pratikop/USV-Electrical-Architecture/pdf/USV_Electrical_Drawings_RevE.pdf

1 | 2 | 3 | 4 | 5 | 6 | 7 | 8
A | A
B | B
C | C
D | D
E | E

# E-001 DESIGN BASIS, SINGLE-LINE ARCHITECTURE AND POWER BUDGET

Independent conceptual study — unbuilt and unvalidated.

## ENV-USV-01 | CIVILIAN WATER-QUALITY MONITORING

## Design basis, single-line architecture and power budget

Author: Pratik Prabhakar Shinde | INDEPENDENT CONCEPT DESIGN

DXF R2013 / Layered vector drawing / A3 landscape

### DRAWING: E-001

REV: E / 17 OCT 2026

STATUS: CONCEPT

PURPOSE: PORTFOLIO

A3 / 420 x 297 mm

SCALE: NTS

UNITS: mm (sheet)

PLOT: 1:1 / LANDSCAPE

## 1. DESIGN BASIS

Mission: 2 h sheltered-water environmental survey; visual supervision and recovery support. Nonconductive 2-3 m hull assumed. Displacement, speed, thrust and battery mass are unresolved. B1: 8S LiFePO4 / 25.6 V nominal / 100 Ah / planning range 22.4-29.2 V.
No charger aboard. Remove/isolate pack for approved shore charging. No AC system in scope.

## 2. FUNCTIONAL SINGLE-LINE (RETURNS OMITTED ON THIS SHEET)

## B1 + BMS

25.6 V / 100 Ah
BMS >=100 A assumed

F0 / Q0

80 A main fuse
2-pole manual isolator

## K1 / F1-F2

Propulsion contactor
2 x 40 A DC feeders

## ESC1 / M1

Port: 300 / 600 W

## ESC2 / M2

Stbd: 300 / 600 W

## F3 / D1 / F5

24 V class -> 12 V
120 W DC/DC; 7.5 A out

## F6-F10 / 12 V SERVICES

Autopilot, GNSS, logger, telemetry, payload 60 W baseline; detailed branches on E-003

## 3. POWER BUDGET - ASSUMED ELECTRICAL INPUTS

LOAD | CRUISE W | PEAK W | BASIS
Propulsion (2 thrusters) | 600 | 1200 | 2 x 300 / 600 W
12 V services | 60 | 60 | D1 output load
D1 conversion loss | 6.7 | 6.7 | 90% efficiency
Permit/control coils | 4 | 4 | Allowance incl. relay drives
TOTAL AT BATTERY | 670.7 | 1270.7 | Simultaneous peak

ENERGY ESTIMATE (NOT MEASURED)

Nominal: 25.6 x 100 = 2560 Wh

Planning: 1843 Wh (SOC x capacity factors)

Mission: 670.7 W x 2 h = 1341 Wh

Estimated endurance: 2.75 h

At 900 W propulsion: 1.90 h

Cable/contact losses not explicitly added.

See calculations/calculations.md.

# E-002 MAIN DC DISTRIBUTION AND PROPULSION FEEDERS

## POWER CIRCUITS / SIMPLIFIED DEVICE SYMBOLS / ALL CONTACTS SHOWN DE-ENERGIZED

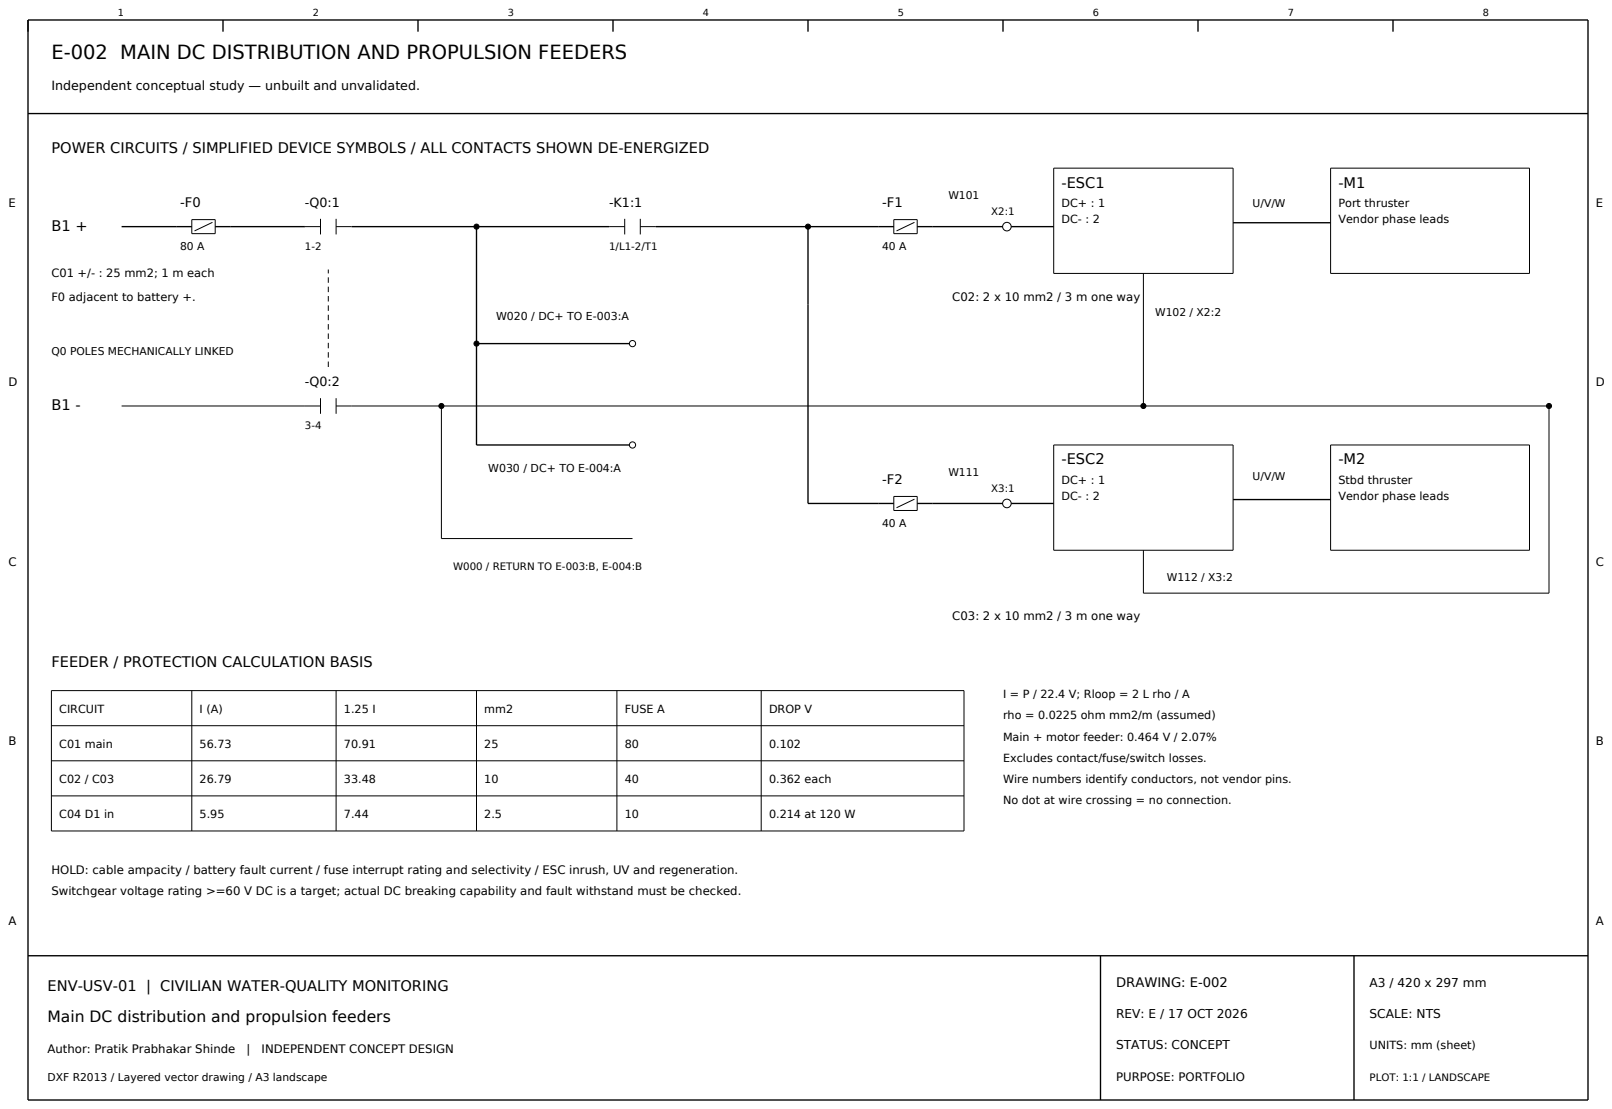
[picture p1: page 2]
DRAWING: E-002; REV: E / 17 OCT 2026; SCALE: NTS; C01 +/- : 25 mm2; 1 m each; -ESC1; C02: 2 x 10 mm2 / 3 m one way; -ESC2; C03: 2 x 10 mm2 / 3 m one way; W000 / RETURN TO E-003:B, E-004:B; I = P / 22.4 V; Rloop = 2 L rho / A

Independent conceptual study — unbuilt and unvalidated.

Port thruster
Vendor phase leads

F0 adjacent to battery +.

Q0 POLES MECHANICALLY LINKED

Stbd thruster

FEEDER / PROTECTION CALCULATION BASIS

CIRCUIT | I (A) | 1.25 I | mm2 | FUSE A | DROP V

rho = 0.0225 ohm mm2/m (assumed)

Main + motor feeder: 0.464 V / 2.07%

C01 main | 56.73 | 70.91 | 25 | 80 | 0.102

Excludes contact/fuse/switch losses.

C02 / C03 | 26.79 | 33.48 | 10 | 40 | 0.362 each

Wire numbers identify conductors, not vendor pins.

No dot at wire crossing = no connection.

HOLD: cable ampacity / battery fault current / fuse interrupt rating and selectivity / ESC inrush, UV and regeneration.
Switchgear voltage rating >=60 V DC is a target; actual DC breaking capability and fault withstand must be checked.

ENV-USV-01 | CIVILIAN WATER-QUALITY MONITORING

Main DC distribution and propulsion feeders

# E-003 12 V SERVICES, FIELD TERMINALS AND SENSOR INTERFACES

## 24 V CLASS TO 12 V SUPPLY / NON-ISOLATED CONVERTER / DEDICATED COPPER RETURNS

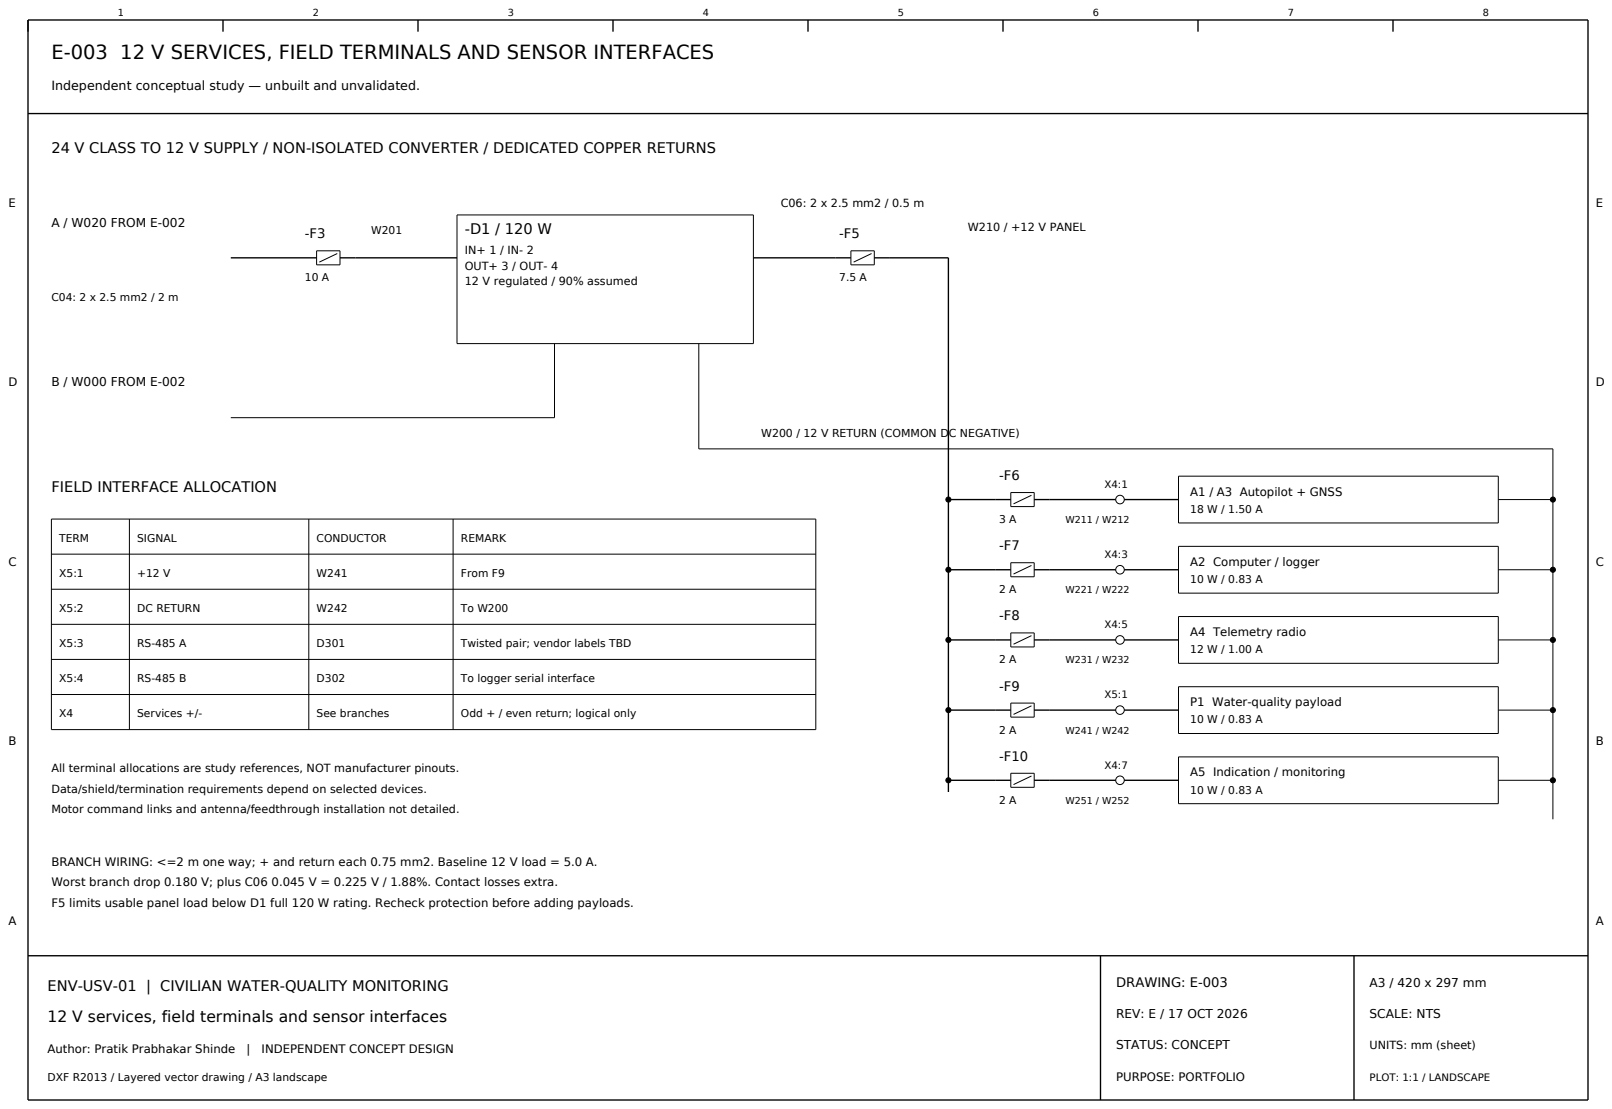
[picture p2: page 3]
DRAWING: E-003; REV: E / 17 OCT 2026; SCALE: NTS; A / W020 FROM E-002; IN+ 1 / IN- 2 OUT+ 3 / OUT- 4 12 V regulated / 90% assumed; W210 / +12 V PANEL; B / W000 FROM E-002; A1 / A3 Autopilot + GNSS; A2 Computer / logger; A4 Telemetry radio; A5 Indication / monitoring

Independent conceptual study — unbuilt and unvalidated.

W200 / 12 V RETURN (COMMON DC NEGATIVE)

FIELD INTERFACE ALLOCATION

TERM | SIGNAL | CONDUCTOR | REMARK

X5:1 | +12 V | W241 | From F9

X5:2 | DC RETURN | W242 | To W200

X5:3 | RS-485 A | D301 | Twisted pair; vendor labels TBD

X5:4 | RS-485 B | D302 | To logger serial interface

P1 Water-quality payload

X4 | Services +/- | See branches | Odd + / even return; logical only

All terminal allocations are study references, NOT manufacturer pinouts.
Data/shield/termination requirements depend on selected devices.
Motor command links and antenna/feedthrough installation not detailed.

BRANCH WIRING: <=2 m one way; + and return each 0.75 mm2. Baseline 12 V load = 5.0 A.
Worst branch drop 0.180 V; plus C06 0.045 V = 0.225 V / 1.88%. Contact losses extra.
F5 limits usable panel load below D1 full 120 W rating. Recheck protection before adding payloads.

ENV-USV-01 | CIVILIAN WATER-QUALITY MONITORING

12 V services, field terminals and sensor interfaces

A | A
B | B
C | C
D | D
E | E

# E-004 PROPULSION PERMIT AND PROPOSED COMMISSIONING PROCEDURES

Independent conceptual study — unbuilt and unvalidated.

## ENV-USV-01 | CIVILIAN WATER-QUALITY MONITORING

## Propulsion permit and proposed commissioning procedures

### DRAWING: E-004

REV: E / 17 OCT 2026

A3 / 420 x 297 mm

SCALE: NTS

## HARDWARE PERMIT PATH - FUNCTIONAL CONTACT DIAGRAM, NOT A RELEASED SAFETY CIRCUIT

A / W030 FROM E-002

-F4

1 A

-S1

11-12 / NC

-SR1

13-14 / NO

-K2

13-14 / NO

-K1

A1 A2

B / W000 TO E-002

W301 | W302 | W303 | W304

C05: 0.75 mm2; 2 m equivalent loop assumption; suppression and relay supply wiring are not detailed.

## -SR1 / MANUAL PERMIT

Functional module; not selected. Requires deliberate reset/arm action. No auto re-arm after power/stop reset. Reset and feedback terminals TBD.

## -K2 / WATCHDOG PERMIT

NO contact only while heartbeat valid. >1 s timeout -> neutral, then open K1. HW/SW implementation not provided. Failure-high behaviour unresolved.

## -K1 / PROPULSION CONTACTOR

Main contact on E-002; auxiliary stays live. Auxiliary feedback needed for fault detection. Coil suppression / drop-out time TBD.
Welded contact can defeat isolation.

### PROPOSED COMMISSIONING PROCEDURES - PRELIMINARY ACCEPTANCE TARGETS / NOT EXECUTED

TEST | METHOD | PROPOSED ACCEPTANCE / HOLD POINT
T01-03 | Pre-energization review | Datasheets, fault current, polarity, torque, return continuity and BMS limits approved.
T04 | Current-limited supply | 12 V panel remains 11.4-12.6 V at 60 W; no reset over intended input range.
T05 | Guarded load emulation | Cable-only propulsion path drop <=3%; ESC input above UV limit; thermal limits met.
T06-07 | Stop / heartbeat loss | Proposed K1 power removal <=0.5 s on local stop; >1 s timeout response; manual re-arm.
T08-09 | Ingress / wet motor setup | Approved facility/procedure; record transients; fault/feedback response reviewed.
T10 | Supervised water trial | 2 h within pack/SOC/thermal limits; log V/I/Wh and conditions; recovery support.

No deliberate pack short circuit. No dry-running water-cooled thrusters. Power removal does not prove stopped thrust or vessel motion.

A | A
B | B
C | C
D | D
E | E

# E-005 CABLE SCHEDULE, PRELIMINARY MATERIALS AND DRAWING NOTES

Independent conceptual study — unbuilt and unvalidated.

## ENV-USV-01 | CIVILIAN WATER-QUALITY MONITORING

## Cable schedule, preliminary materials and drawing notes

### DRAWING: E-005

REV: E / 17 OCT 2026

A3 / 420 x 297 mm

SCALE: NTS

## CABLE TAKE-OFF - CONDUCTOR-METRES, INCLUDING 20% ROUTING ALLOWANCE

ID | FROM / TO | L ONE-WAY | CORE mm2 | CORES | PROV. m | PROTECTION / HOLD
C01 | B1 / F0 / Q0 / DC bars | 1.0 m | 25 | 2 | 2.4 | F0 80 A / assumed Iz 100 A
C02 | K1 / F1 / ESC1 + return | 3.0 m | 10 | 2 | 7.2 | F1 40 A / assumed Iz 50 A
C03 | K1 / F2 / ESC2 + return | 3.0 m | 10 | 2 | 7.2 | F2 40 A / assumed Iz 50 A
C04 | F3 / D1 input + return | 2.0 m | 2.5 | 2 | 4.8 | F3 10 A / assumed Iz 20 A
C05 | F4 / stop-permit / K1 coil | 2.0 m eq. | 0.75 | 2 eq. | 4.8 | F4 1 A / assumed Iz 5 A
C06 | D1 / F5 / 12 V panel | 0.5 m | 2.5 | 2 | 1.2 | F5 7.5 A / assumed Iz 20 A
12V-BR | F6-F10 / service loads | 2 m each | 0.75 | 2 x 5 | 24.0 | F6 3 A; F7-F10 2 A

## PRELIMINARY FUNCTIONAL BOM (NO PART NUMBERS OR COST CLAIM)

TAG | QTY | FUNCTIONAL SPECIFICATION | RELEASE HOLD
B1 / F0 / Q0 | 1 set | 25.6 V 100 Ah; 80 A fuse; >=100 A isolator | Fault current, BMS, DC break, mass
K1 / ESC / M | 1/2/2 | >=100 A contactor; 600 W peak per propulsion branch | ESC UV <=21 V; inrush / regen / cooling
D1 / F3-F10 | 1 set | 12 V 120 W DC/DC and branch fuse/holder set | Actual voltage range, protection coordination
S1 / SR1 / K2 | 1 each | NC local stop; manual permit; watchdog permit | Exact reset / feedback and fault behaviour
A1-A5 / P1 | 1 set | Autopilot, GNSS, logger, radio, monitoring, sensors | Supply compatibility, data protocols and EMC
ENC / cabling | 1 lot | Sealed enclosure, glands, connectors, copper, terminals | IP67 assembly target; heat / corrosion review

## GENERAL DRAWING / DESIGN NOTES

1. NTS schematic sheets. Model-space coordinates are paper mm. Open DXF in AutoCAD; plot A3 landscape 1:1.
2. Simplified conventional symbols only. Tags/terminal allocations are illustrative, not vendor connection instructions.
3. All ampacities are assumptions. Validate installation derating, connector ratings and fuse curves before design release.
4. Single battery, BMS and converter remain common failure points. No redundancy or standards compliance is claimed.
5. Rev E: consolidated portfolio presentation. Electrical architecture and analytical sizing are unchanged.
6. Sources: Victron Wiring Unlimited, DC wiring; Blue Sea Systems Circuit Protection. Full links in docs/engineering_brief.md.
7. Results are analytical estimates. Commissioning procedures are proposed and have not been executed.
