pratikop/USV-Electrical-Architecture/cad/E-002.dxf

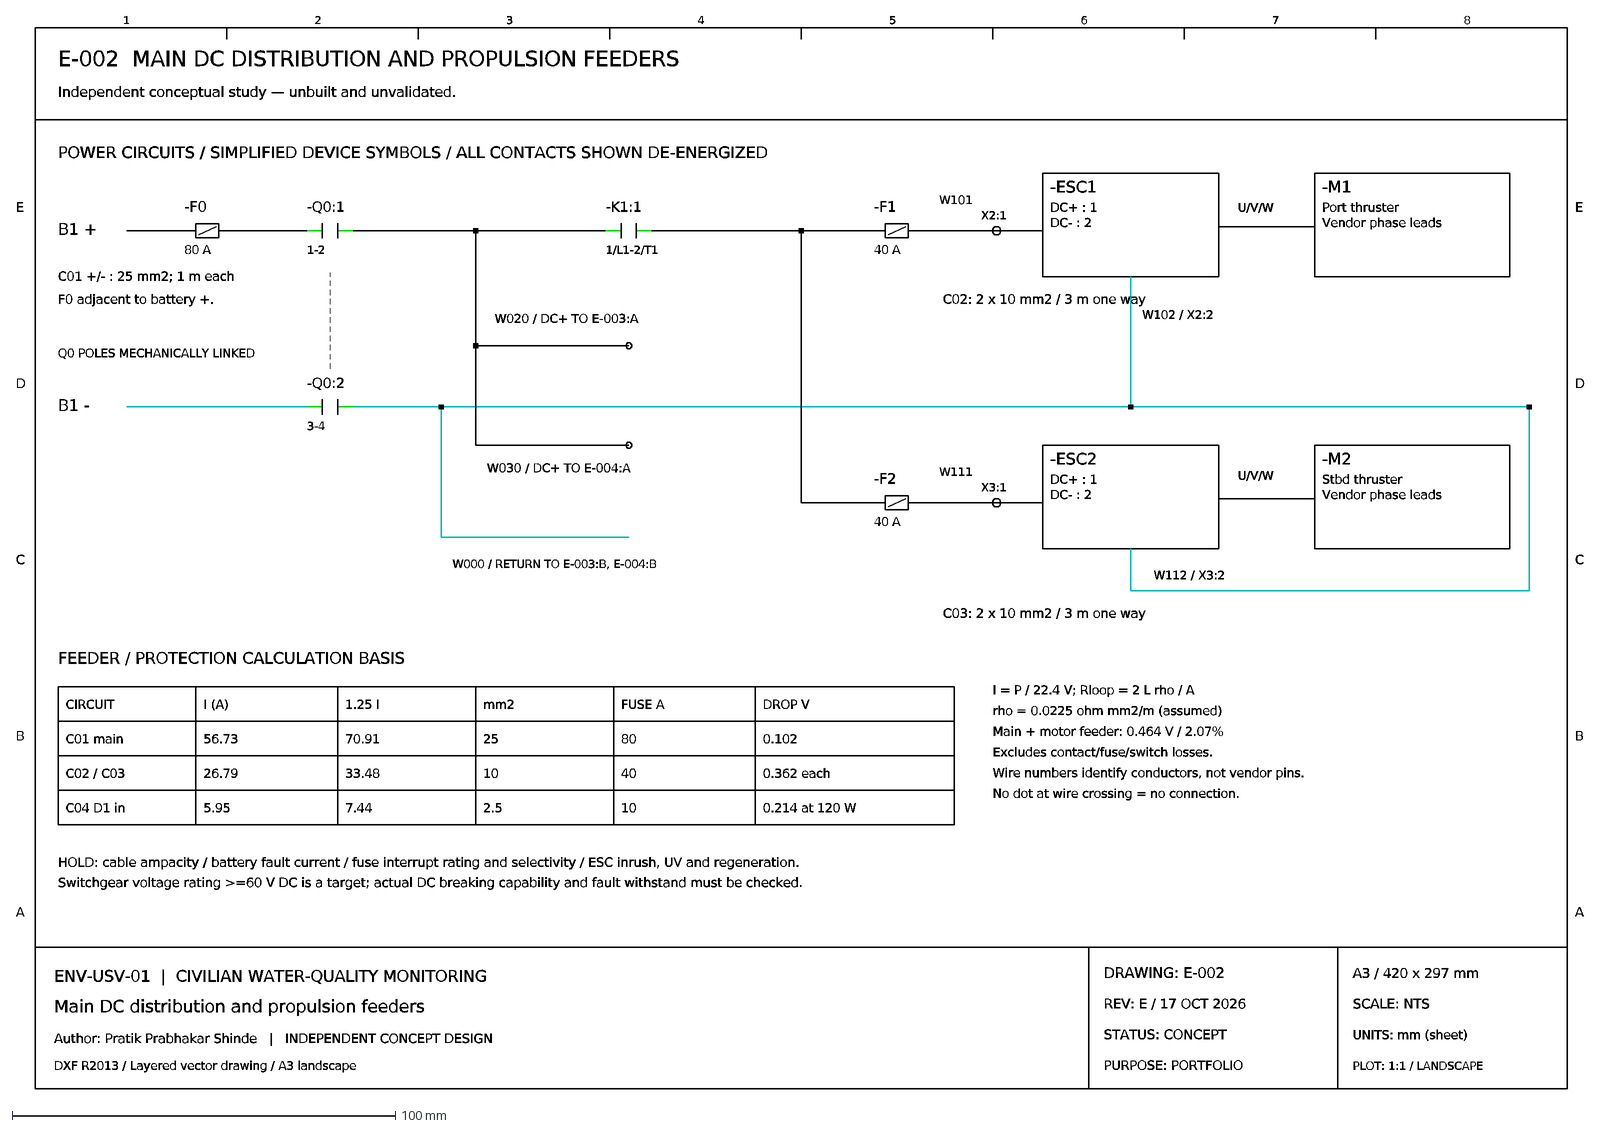
[picture p3: CAD file, 2026-10-17]
cad/E-002.dxf
1
2
3
4
5
6
7
8
A
B
C
D
E
E-002 MAIN DC DISTRIBUTION AND PROPULSION FEEDERS
Independent conceptual study — unbuilt and unvalidated.
ENV-USV-01 | CIVILIAN WATER-QUALITY MONITORING
Main DC distribution and propulsion feeders
Author: Pratik Prabhakar Shinde | INDEPENDENT CONCEPT DESIGN
DXF R2013 / Layered vector drawing / A3 landscape
DRAWING: E-002
REV: E / 17 OCT 2026
STATUS: CONCEPT
PURPOSE: PORTFOLIO
A3 / 420 x 297 mm
SCALE: NTS
UNITS: mm (sheet)
PLOT: 1:1 / LANDSCAPE
POWER CIRCUITS / SIMPLIFIED DEVICE SYMBOLS / ALL CONTACTS SHOWN DE-ENERGIZED
B1 +
-F0
80 A
-Q0:1
1-2
B1 -
-Q0:2
3-4
Q0 POLES MECHANICALLY LINKED
C01 +/- : 25 mm2; 1 m each
F0 adjacent to battery +.
-K1:1
1/L1-2/T1
-F1
40 A
X2:1
W101
-ESC1
DC+ : 1
DC- : 2
-M1
Port thruster
Vendor phase leads
U/V/W
W102 / X2:2
C02: 2 x 10 mm2 / 3 m one way
-F2
X3:1
W111
-ESC2
W112 / X3:2
-M2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
