pratikop/USV-Electrical-Architecture/cad/E-003.dxf

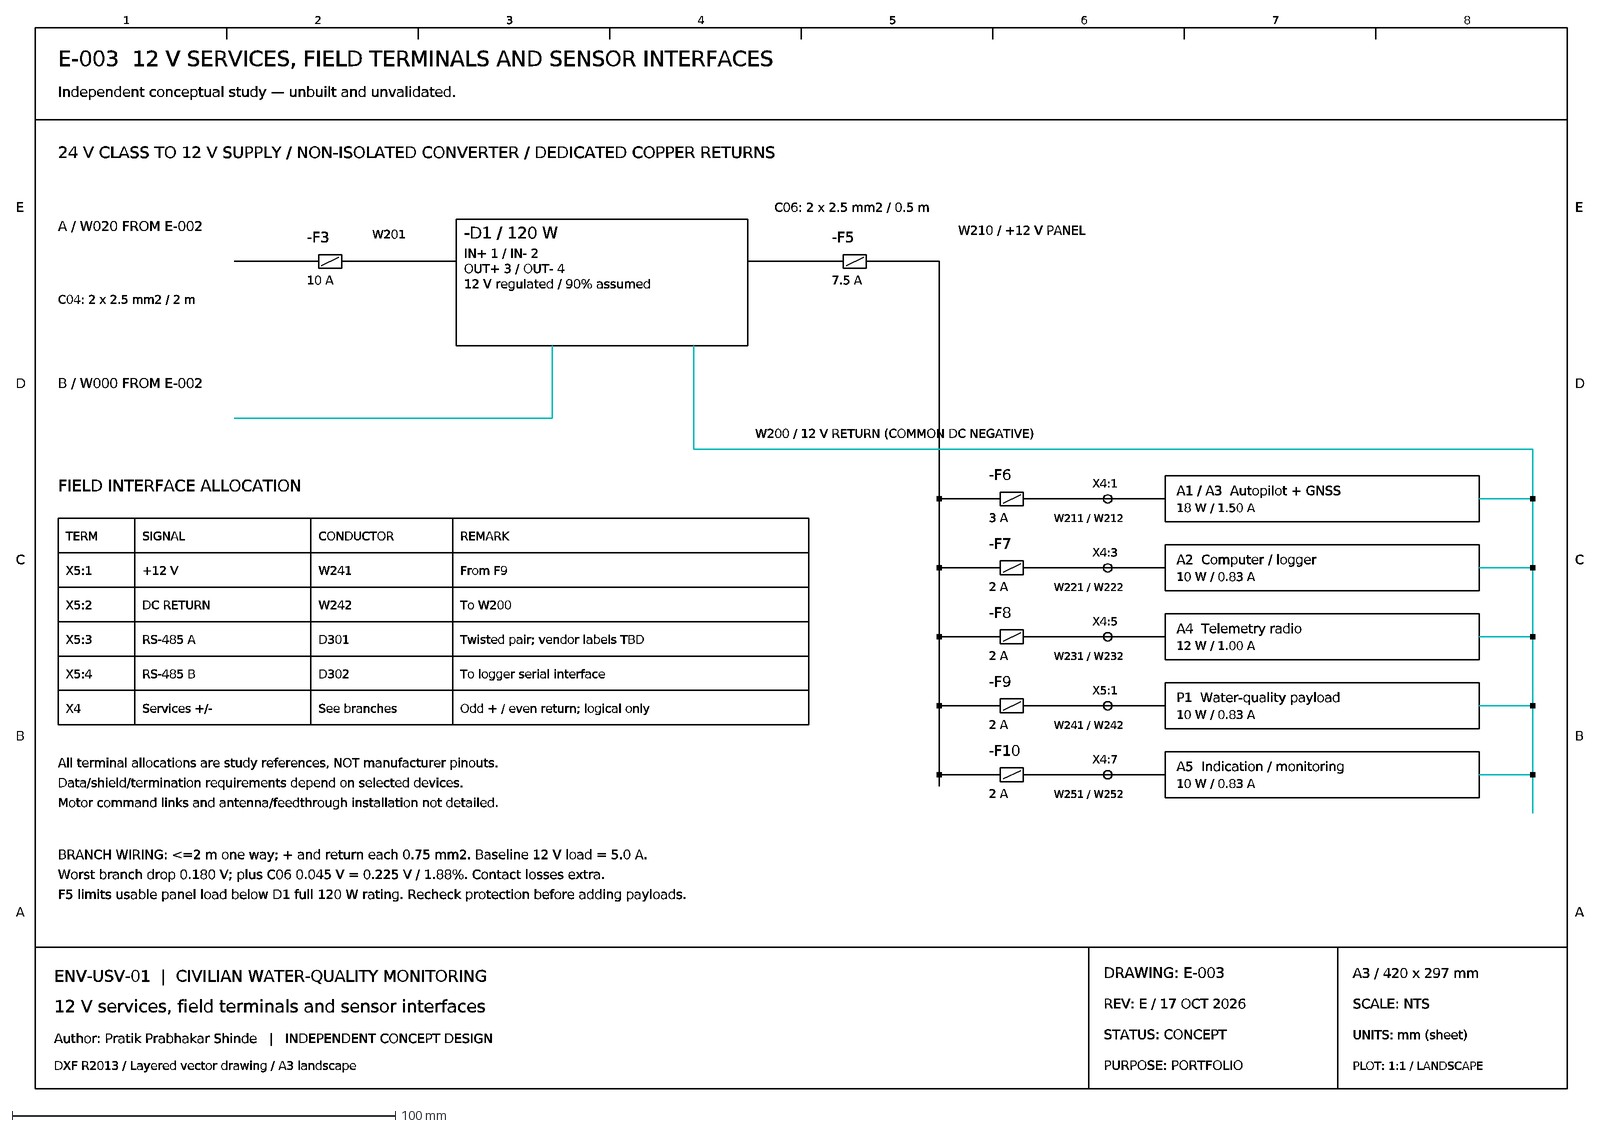
[picture p4: CAD file, 2026-10-17]
cad/E-003.dxf
1
2
3
4
5
6
7
8
A
B
C
D
E
E-003 12 V SERVICES, FIELD TERMINALS AND SENSOR INTERFACES
Independent conceptual study — unbuilt and unvalidated.
ENV-USV-01 | CIVILIAN WATER-QUALITY MONITORING
12 V services, field terminals and sensor interfaces
Author: Pratik Prabhakar Shinde | INDEPENDENT CONCEPT DESIGN
DXF R2013 / Layered vector drawing / A3 landscape
DRAWING: E-003
REV: E / 17 OCT 2026
STATUS: CONCEPT
PURPOSE: PORTFOLIO
A3 / 420 x 297 mm
SCALE: NTS
UNITS: mm (sheet)
PLOT: 1:1 / LANDSCAPE
24 V CLASS TO 12 V SUPPLY / NON-ISOLATED CONVERTER / DEDICATED COPPER RETURNS
A / W020 FROM E-002
-F3
10 A
W201
-D1 / 120 W
IN+ 1 / IN- 2
OUT+ 3 / OUT- 4
12 V regulated / 90% assumed
-F5
7.5 A
C06: 2 x 2.5 mm2 / 0.5 m
W210 / +12 V PANEL
B / W000 FROM E-002
W200 / 12 V RETURN (COMMON DC NEGATIVE)
C04: 2 x 2.5 mm2 / 2 m
-F6
3 A
X4:1
W211 / W212
A1 / A3 Autopilot + GNSS
18 W / 1.50 A
-F7
2 A
X4:3
W221 / W222
A2 Computer / logger
10 W / 0.83 A
-F8
X4:5
W231 / W232
A4 Telemetry radio
12 W / 1.00 A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
