pratikop/USV-Electrical-Architecture/cad/E-005.dxf

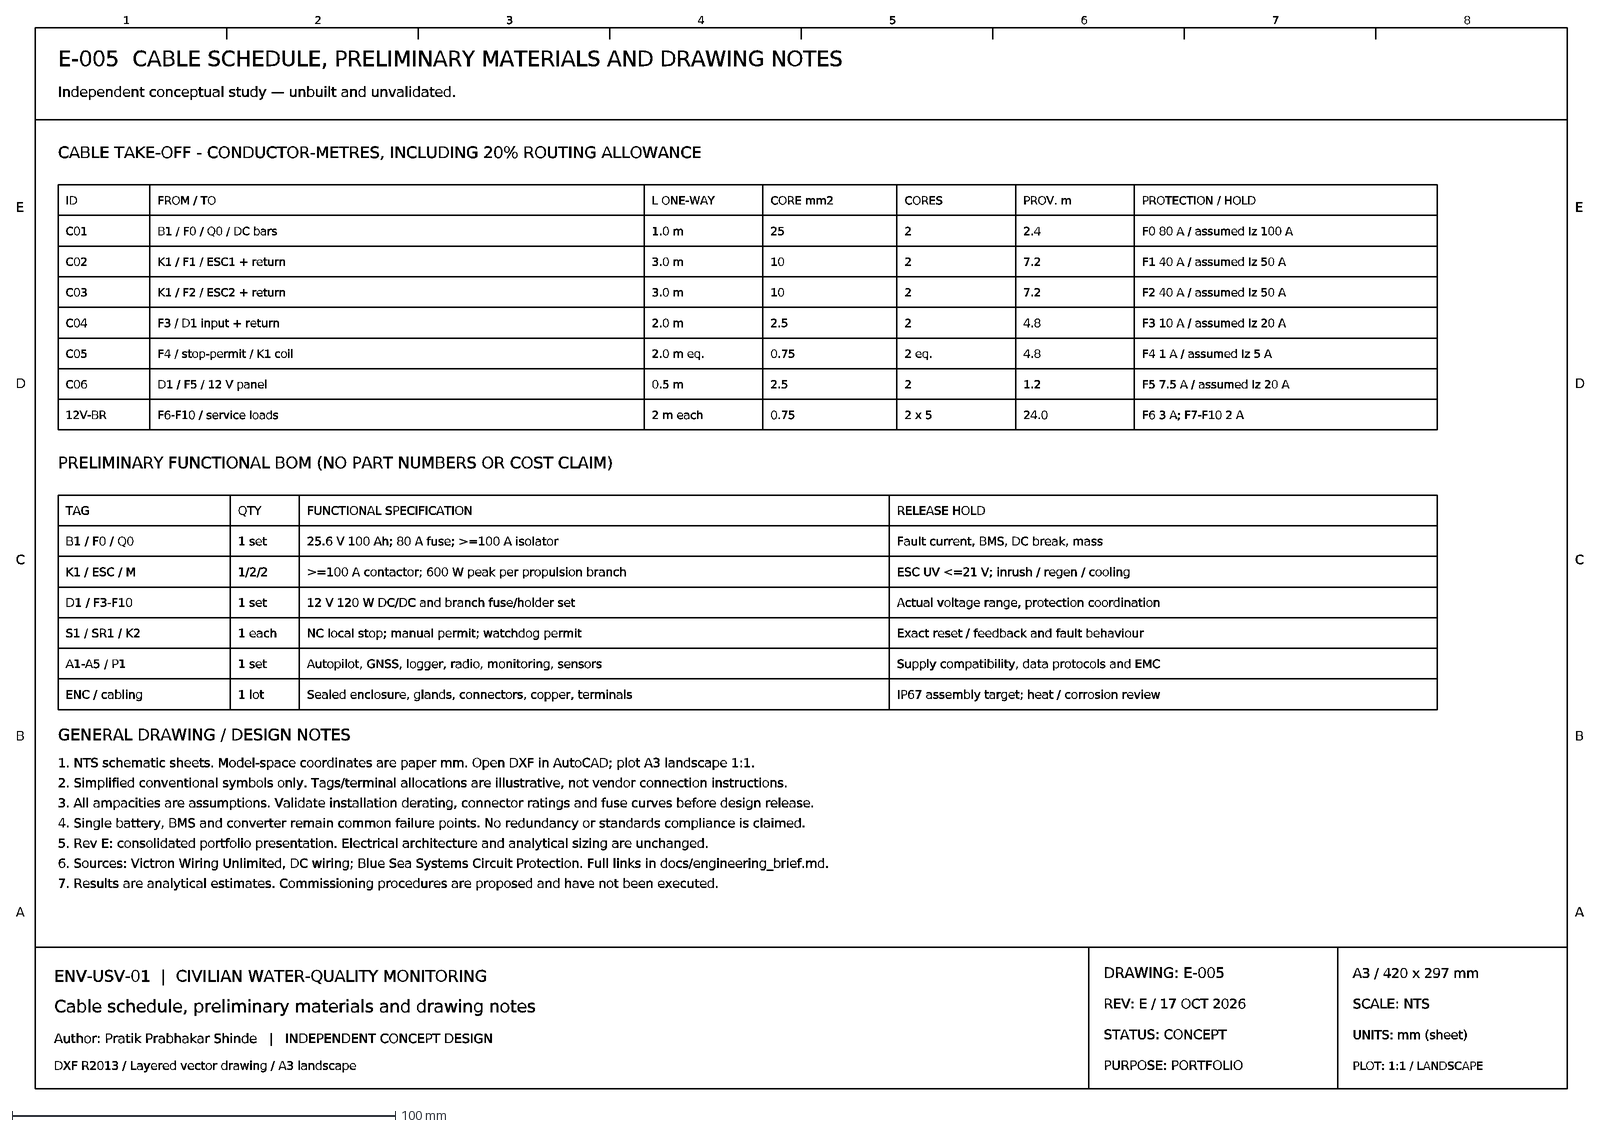
[picture p5: CAD file, 2026-10-17]
cad/E-005.dxf
1
2
3
4
5
6
7
8
A
B
C
D
E
E-005 CABLE SCHEDULE, PRELIMINARY MATERIALS AND DRAWING NOTES
Independent conceptual study — unbuilt and unvalidated.
ENV-USV-01 | CIVILIAN WATER-QUALITY MONITORING
Cable schedule, preliminary materials and drawing notes
Author: Pratik Prabhakar Shinde | INDEPENDENT CONCEPT DESIGN
DXF R2013 / Layered vector drawing / A3 landscape
DRAWING: E-005
REV: E / 17 OCT 2026
STATUS: CONCEPT
PURPOSE: PORTFOLIO
A3 / 420 x 297 mm
SCALE: NTS
UNITS: mm (sheet)
PLOT: 1:1 / LANDSCAPE
CABLE TAKE-OFF - CONDUCTOR-METRES, INCLUDING 20% ROUTING ALLOWANCE
ID
FROM / TO
L ONE-WAY
CORE mm2
CORES
PROV. m
PROTECTION / HOLD
C01
B1 / F0 / Q0 / DC bars
1.0 m
25
2.4
F0 80 A / assumed Iz 100 A
C02
K1 / F1 / ESC1 + return
3.0 m
10
7.2
F1 40 A / assumed Iz 50 A
C03
K1 / F2 / ESC2 + return
F2 40 A / assumed Iz 50 A
C04
F3 / D1 input + return
2.0 m
2.5
4.8
F3 10 A / assumed Iz 20 A
C05
F4 / stop-permit / K1 coil
2.0 m eq.
0.75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
