pratikop/USV-Electrical-Architecture/cad/E-001.dxf

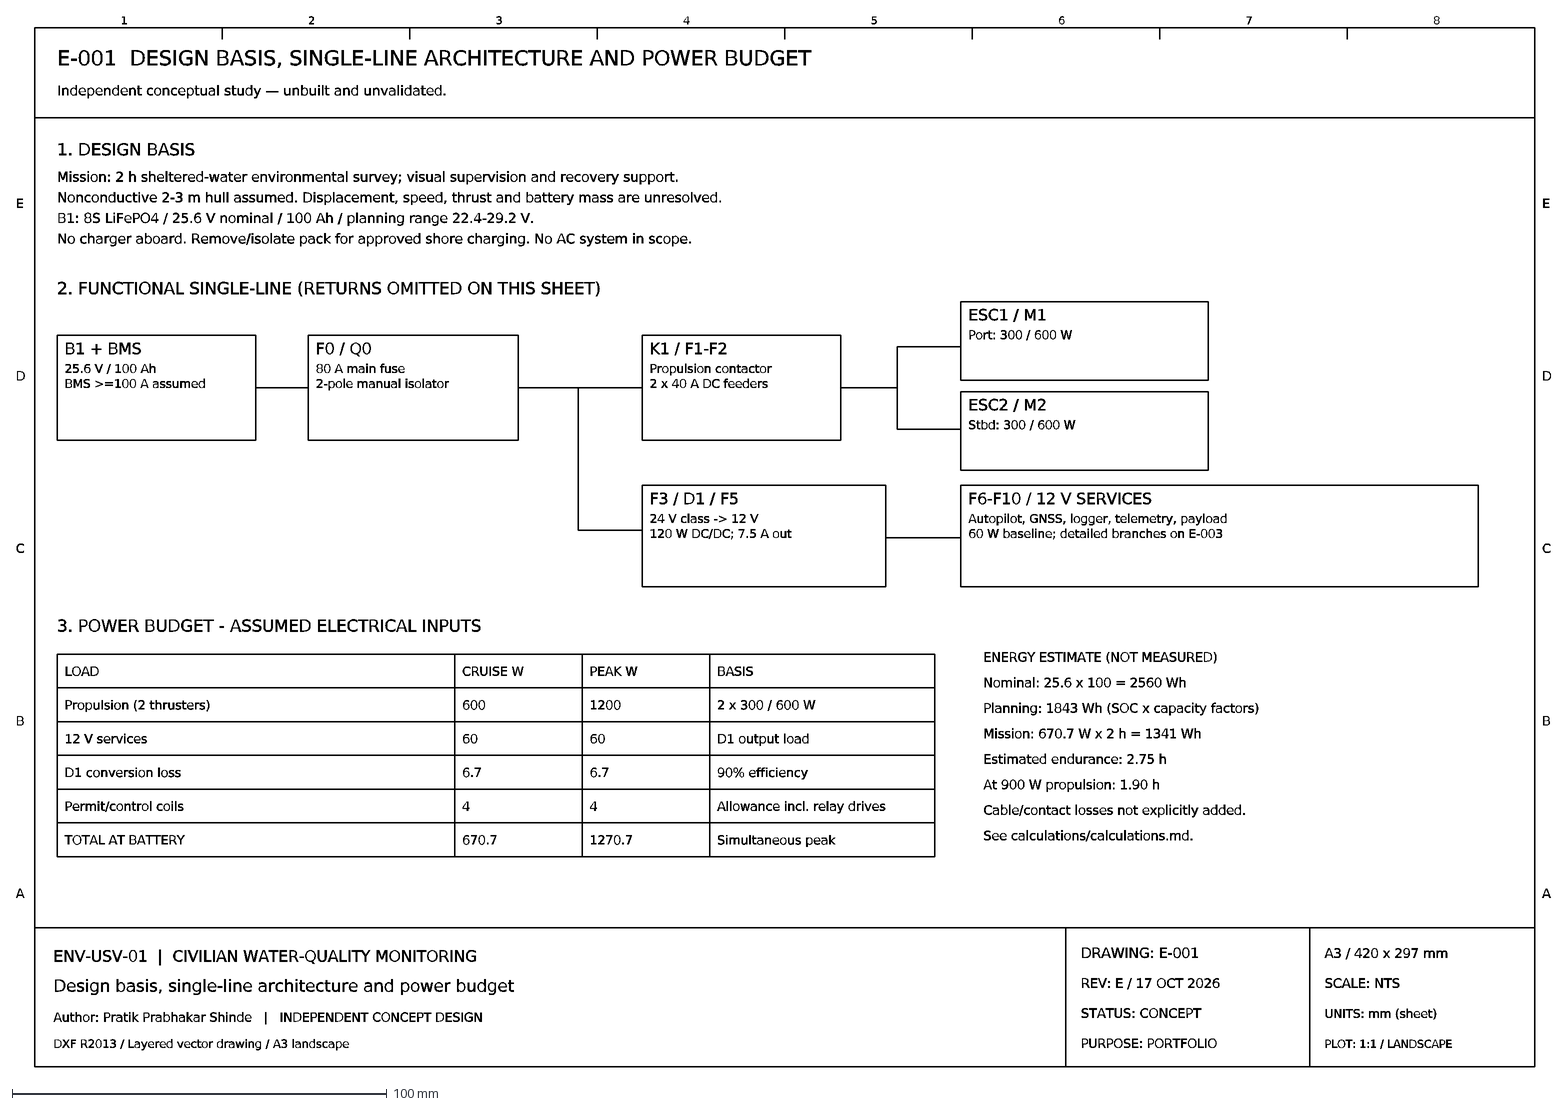
[picture p6: CAD file, 2026-10-17]
cad/E-001.dxf
1
2
3
4
5
6
7
8
A
B
C
D
E
E-001 DESIGN BASIS, SINGLE-LINE ARCHITECTURE AND POWER BUDGET
Independent conceptual study — unbuilt and unvalidated.
ENV-USV-01 | CIVILIAN WATER-QUALITY MONITORING
Design basis, single-line architecture and power budget
Author: Pratik Prabhakar Shinde | INDEPENDENT CONCEPT DESIGN
DXF R2013 / Layered vector drawing / A3 landscape
DRAWING: E-001
REV: E / 17 OCT 2026
STATUS: CONCEPT
PURPOSE: PORTFOLIO
A3 / 420 x 297 mm
SCALE: NTS
UNITS: mm (sheet)
PLOT: 1:1 / LANDSCAPE
1. DESIGN BASIS
Mission: 2 h sheltered-water environmental survey; visual supervision and recovery support.
Nonconductive 2-3 m hull assumed. Displacement, speed, thrust and battery mass are unresolved.
B1: 8S LiFePO4 / 25.6 V nominal / 100 Ah / planning range 22.4-29.2 V.
No charger aboard. Remove/isolate pack for approved shore charging. No AC system in scope.
2. FUNCTIONAL SINGLE-LINE (RETURNS OMITTED ON THIS SHEET)
B1 + BMS
25.6 V / 100 Ah
BMS >=100 A assumed
F0 / Q0
80 A main fuse
2-pole manual isolator
K1 / F1-F2
Propulsion contactor
2 x 40 A DC feeders
ESC1 / M1
Port: 300 / 600 W
ESC2 / M2
Stbd: 300 / 600 W
F3 / D1 / F5
24 V class -> 12 V
120 W DC/DC; 7.5 A out
F6-F10 / 12 V SERVICES
Autopilot, GNSS, logger, telemetry, payload
60 W baseline; detailed branches on E-003
3. POWER BUDGET - ASSUMED ELECTRICAL INPUTS
LOAD
CRUISE W
PEAK W
BASIS
Propulsion (2 thrusters)
600
1200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
