pratikop/USV-Electrical-Architecture/cad/E-004.dxf

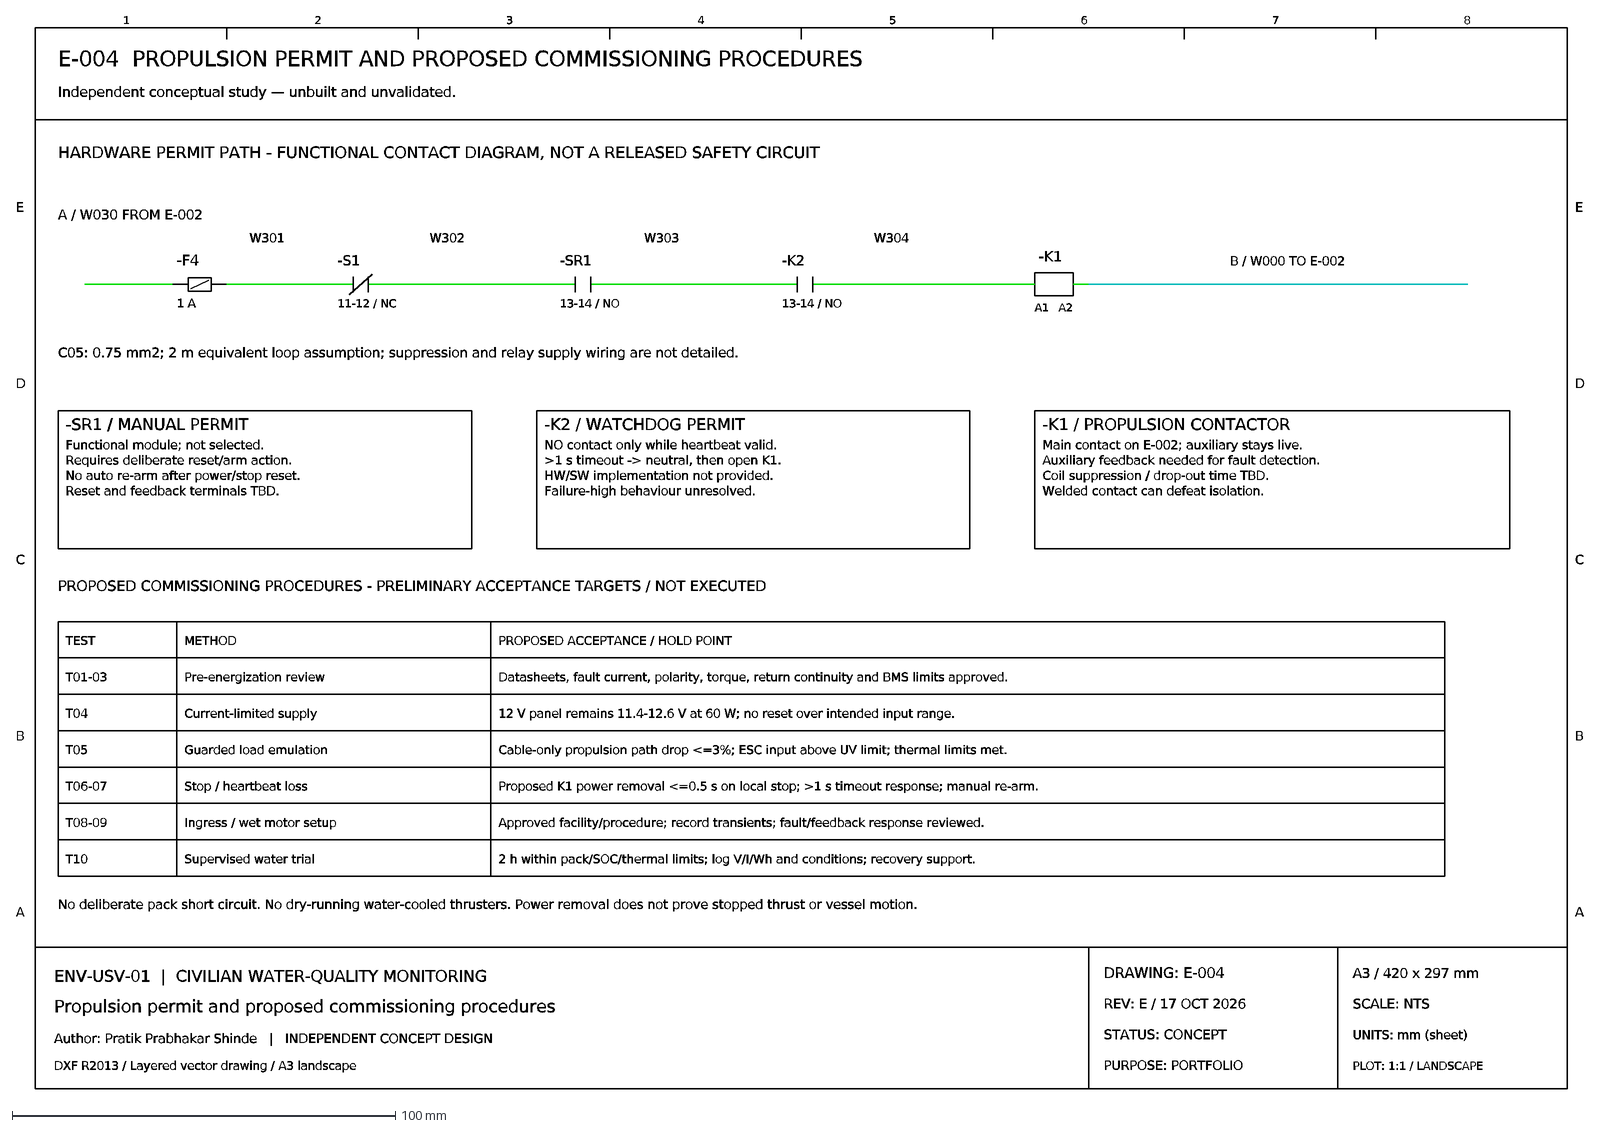
[picture p7: CAD file, 2026-10-17]
cad/E-004.dxf
1
2
3
4
5
6
7
8
A
B
C
D
E
E-004 PROPULSION PERMIT AND PROPOSED COMMISSIONING PROCEDURES
Independent conceptual study — unbuilt and unvalidated.
ENV-USV-01 | CIVILIAN WATER-QUALITY MONITORING
Propulsion permit and proposed commissioning procedures
Author: Pratik Prabhakar Shinde | INDEPENDENT CONCEPT DESIGN
DXF R2013 / Layered vector drawing / A3 landscape
DRAWING: E-004
REV: E / 17 OCT 2026
STATUS: CONCEPT
PURPOSE: PORTFOLIO
A3 / 420 x 297 mm
SCALE: NTS
UNITS: mm (sheet)
PLOT: 1:1 / LANDSCAPE
HARDWARE PERMIT PATH - FUNCTIONAL CONTACT DIAGRAM, NOT A RELEASED SAFETY CIRCUIT
A / W030 FROM E-002
-F4
1 A
-S1
11-12 / NC
-SR1
13-14 / NO
-K2
-K1
A1 A2
B / W000 TO E-002
W301
W302
W303
W304
C05: 0.75 mm2; 2 m equivalent loop assumption; suppression and relay supply wiring are not detailed.
-SR1 / MANUAL PERMIT
Functional module; not selected.
Requires deliberate reset/arm action.
No auto re-arm after power/stop reset.
Reset and feedback terminals TBD.
-K2 / WATCHDOG PERMIT
NO contact only while heartbeat valid.
>1 s timeout -> neutral, then open K1.
HW/SW implementation not provided.
Failure-high behaviour unresolved.
-K1 / PROPULSION CONTACTOR
Main contact on E-002; auxiliary stays live.
Auxiliary feedback needed for fault detection.
Coil suppression / drop-out time TBD.
Welded contact can defeat isolation.
PROPOSED COMMISSIONING PROCEDURES - PRELIMINARY ACCEPTANCE TARGETS / NOT EXECUTED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
