pratikop/USV-Electrical-Architecture/(commit log)

2026-10-16 Add Rev B USV electrical DXF drawing set and analytical study
    [E-001.dxf, E-002.dxf, E-003.dxf, E-004.dxf, E-005.dxf]
2026-10-16 Clarify concept maturity and engineering evidence; issue drawing revision C
    [E-001.dxf, E-002.dxf, E-003.dxf, E-004.dxf, E-005.dxf]
2026-10-17 Issue Rev D: standardize author credits and auxiliary-load terminology
    [E-001.dxf, E-002.dxf, E-003.dxf, E-004.dxf, E-005.dxf]
2026-10-17 Prepare portfolio presentation: concise README and technical deliverables
    [E-001.dxf, E-002.dxf, E-003.dxf, E-004.dxf, E-005.dxf]
2026-10-17 Document AutoCAD as CAD environment with author-confirmed DXF compatibility
